kylecombes/poe-3d-ir-scanner/report/PoE-lab-2-report.pdf

# PoE Lab 2 - 3D Scanner

## Kyle Combes and Rachel Hwang

## September 26, 2017

Abstract

In this lab, we used an Arduino, two servos, and an infrared rangefinder to construct a 3D plot of a large ’R’ cut out of cardboard. Data was minorly preprocessed on the Arduino before being sent to a computer via serial for more processing and display. In the end, a 3D scatter plot was generated depicting the scanned object.

## 1 Constructing the 3D Scanner

Using SolidWorks, we designed parts to create a 3D scanner that includes two hobby servo motors and an infrared distance sensor. All parts were made intended to be laser cut out of 3/16” hardboard that could be wedged together. The bottom servo motor sat in a box base acting as the panning mechanism. Attached above to the side is the second servo motor creating the tilt mechanism for the sensor attached in the middle of the two axes. This ensured that the sensor’s center would not change when it panned or tilted.
Our SolidWorks model can be seen in Figure 1, and our final, physical scanner can be seen in Figure 2.

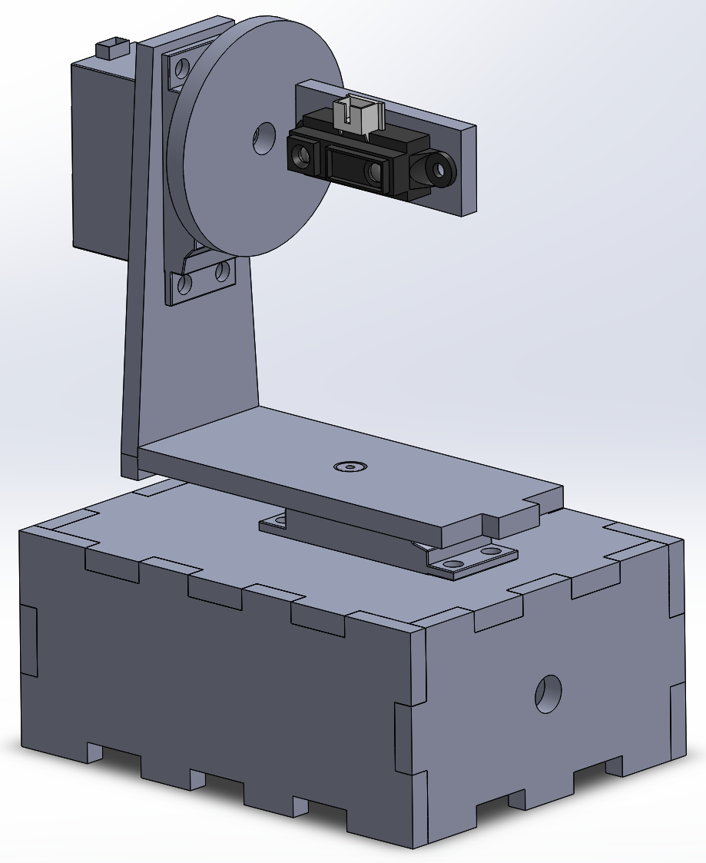
[picture p3: figure]

### Figure 1: The SolidWorks model of the 3D scanner

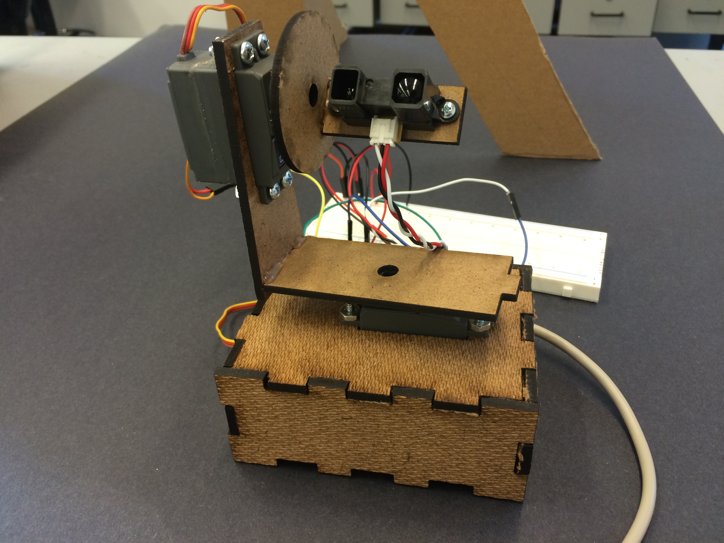
[picture p4: figure]

### Figure 2: The model made from laser cut hardwood of the 3D scanner

## 2 Calibrating the Rangefinder

The first step to using a rangefinder to accurately measure distances was to calibrate it. This would allow us to convert the value read from the sensor to an actual distance.
The value read from the IR sensor was in the range of 0 to 1023, since the Arduino uses a 10-bit analog to digital converter to read the input voltage. However, it seemed like an unnecessary extra step to us to convert this value to a voltage and then map that voltage to a distance value. Thus, we decided to directly map the 10-bit value to a distance in inches.
To calibrate the sensor, we placed a large piece of cardboard in front of the IR sensor. Using the serial monitor in the Arduino IDE, we observed the raw readings from the IR sensor and picked the mode of ten to twenty consecutive readings to be our measured value for that distance. Then we moved the cardboard back two to three inches and repeated the process. Our collected data can be seen in Figure 3.

### Switching our independent and dependent variables allowed us to look at the distance as a

function of sensor reading. Using the polyfit function in MATLAB, we were able to extract the

### quartic function y = 5.24 × 10⁻⁹x

4 − 8.33 × 10⁻⁶x

3 + 4.83 × 10⁻³x
2 − 1.26x + 1.41 × 10²

### , which

related the raw sensor reading to the distance. This is illustrated in Figure 4.

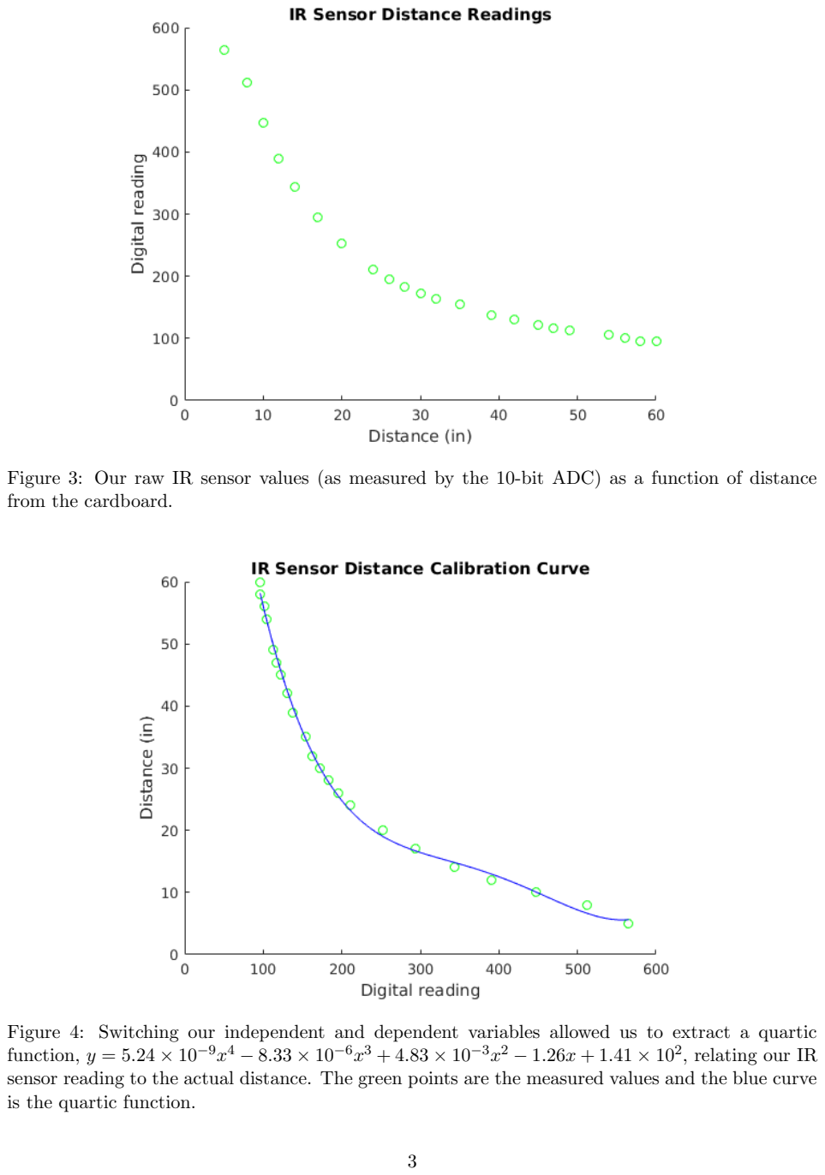
[picture p5: page 3]

Figure 3: Our raw IR sensor values (as measured by the 10-bit ADC) as a function of distance from the cardboard.

Figure 4: Switching our independent and dependent variables allowed us to extract a quartic

### function, y = 5.24 × 10⁻⁹x

4 − 8.33 × 10⁻⁶x

3 + 4.83 × 10⁻³x
2 − 1.26x + 1.41 × 10²

### , relating our IR

sensor reading to the actual distance. The green points are the measured values and the blue curve is the quartic function.

## 2.1 Error Plot

In order to check our calibration, we took some new measurements at various distances from the cardboard and checked the output of our function against the actual distance measurements. If our calibration were perfect, all of the points would lie on the line y = x because there would be a 1:1 correlation between the measured and actual values. In practice, the calculated values were typically within an inch of the correct value (see Figure 5).
However, it appears that the error would be significantly decreased if the line were shifted slightly to the left. This discrepancy could be due to the fact that the calibration and error plots were done under different lighting conditions (daytime and nighttime). The sunlight during the calibration session could’ve shifted all of the readings (since sunlight contains IR light). Without that constant influx, the readings would’ve all shifted by the same amount.

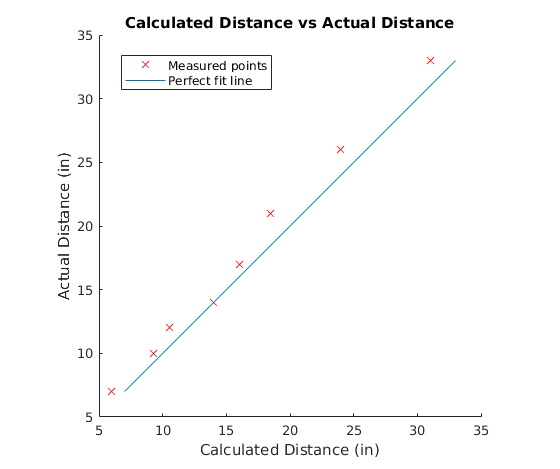
[picture p6: figure]

Figure 5: Some testing of our calibration curve showed that we were typically interpreted the distance within 1 inch of its correct value. However, the data may have been skewed slightly due to different lighting conditions during calibration and testing.

## 3 Collecting the Scan Data with the Arduino

Once the IR rangefinder was calibrated and mounted, we programmed the Arduino to sweep back and forth, collecting data points. Since we were panning and tilting about the origin and reading distances from the origin, this meant we were dealing with spherical coordinates. We decided to deal entirely with spherical coordinates on the Arduino and send them to the computer in that format.
We defined θmin, θmax, φmin, and φmax to restrict our ranges to 80 ≤ θ ≤ 100 and 75 ≤ φ ≤ 120. This helped minimize scanning time and avoid scanning unwanted nearby objects. We also defined thetaStep and phiStep to determine our angle deltas for each step. We settled on a value of 1 for both, so that we collected points every degree in each direction.

### To actually collect the data, the Arduino began with the pan servo at θmin and the tilted

servo at φmin. It then sampled the IR sensor twenty times and computed the mean distance, in order to avoid any erroneous readings throwing us off. Once it computed the mean, the value was transmitted to the computer along with the values for θ and φ as a tab-separated string.
Then, if θ was at the end of its range, the scanner tilted, collected another scan point, and reversed thetaStep to pan in the other direction. Once the scanner reached θmax and φmax, it reversed directions and began the scan again.

## 4 Visualizing the Scan

### On the computer, a Python program received the data sent by the Arduino over serial. Upon

receiving a transmission, several steps were required before a final figure could be generated.

## 4.1 Converting from Spherical to Cartesian

The first steps to handling the Arduino transmission were to decode the tab-separated string of values and convert them from spherical coordinates to Cartesian using the following equations (where r was the measured distance and θ and φ were the angles, as illustrated in Figure 6).

### x = rsin(φ)cos(θ)

### y = rsin(φ)sin(θ)

### z = rcost(φ)

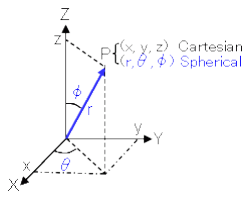
[picture p7: figure]

Figure 6: The spherical coordinate system used by the 3D scanner. Points were converted to Cartesian on the computer before plotting.

Once the point was converted to Cartesian, it was stored in a PointsCollection data structure. The PointsCollection data structure was designed to be configurable to only store a certain number of points such that, once the limit was reached, the oldest data point would be dropped. This allowed the scanner to keep running and scan new objects, discarding the oldest points as it progressed. For our scans, we decided to only keep one point for each value of θ and φ, so our max number of points was (θmax − θmin)(φmax − φmin) = 900.

## 4.2 Taking a 2D Scan

Taking a cross-sectional slice of the ’R’ (just above where the lines converged in the middle) resulted in Figure 7. In order to take the scan, the full pan-tilt setup (Figure 2) was used, but the tilt functionality was simply disabled.
At the bottom of the scan, where y < 20, you can see where the scanner picked up the middle of the R. The rest of the points at further distances are either noise or objects picked up in the background.

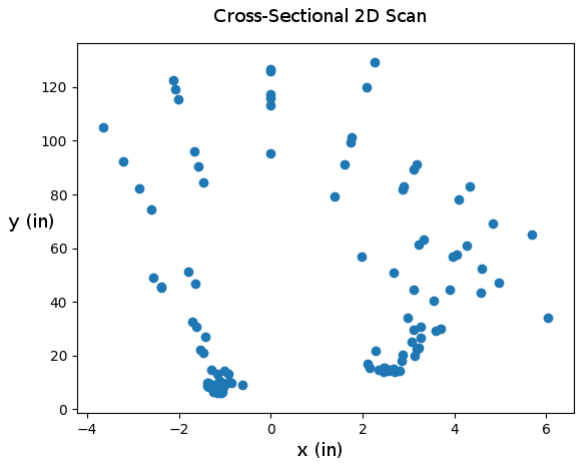
[picture p8: figure]

Figure 7: Taking a 2D scan of the middle of the ’R’ (just above where the lines converge in the middle of the letter) results in a cross-sectional view of the letter. At the bottom of the scan, where y < 20, you can see where the scanner picked up the R.

## 4.3 Cleaning the Data

We also defined a parameter in our program, MAX DIST, to ignore points more than a specific distance from the scanner. This helped to filter out anything the scanner picked up behind the object we were attempting to scan. Since we placed the letter we were scanning about 10-15 inches away from the scanner, we decided 30 inches was a good cutoff point. This way we could see if the scanner ever got confused and thought that the letter was a little further away than it actually was, but we also avoided plotting any background objects.

## 4.4 Plotting the Points

Once the points were filtered and converted to Cartesian, we plotted them in 3D using the Python library matplotlib. The results can be seen in Figure 8.


Figure 8: Our scanned cardboard letter ”R” after minimal filtering.

## 5 Conclusion

All in all, our scanner performed quite admirably. We initially ran into some trouble with inconsistent distance readings, which caused our object to be indistinguishable on the scan, but we learned that the IR sensor needed around 50ms to perform a scan and adjusted our code accordingly. This made the scan much, much cleaner.
Even so, there was a fair bit of noise in the top-right corner. We think this might be due to inconsistent servo tilt deltas, as it often appeared as though the scanner tilted more some times than others. However, the slanted leg of the ’R’ appeared pretty crisp, so perhaps it was not the cause. Confirming or disproving this would require closer monitoring of the scanner during scanning and perhaps measures the changes in the angle.
The ground is also noticeable in the bottom of the scan, but that is just an artifact caused by the conditions of the scan. To get rid of it (without simply cropping the image), one would have to suspend the letter in the air, perhaps with some thin thread. But that’s beyond the scope of this project.

## 6 Code

The full source code can also be found in this GitHub repository.

## 6.1 MATLAB Calibration

1 | % C ali b r a ti o n data
2 | d i s t = [ 5 8 10 12 14 17 20 24 26 28 30 32 35 39 42 45 47 49 54 56 58 6 0 ] ;
3 | r e a di n g = [ 5 6 5 512 447 390 343 294 252 211 195 183 172 163 154 138 130 122 117 113
| 105 101 96 9 6 ] ;

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

% Pl o t the p oi n t s
pl o t ( di s t , re adin g , ’ go ’ ) ;

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

%% Make an e r r o r pl o t
c a l c u l a t e d = [ 6 9. 3 1 0. 5 14 16 1 8. 5 24 3 1 ] ; a c t u al = [ 7 10 12 14 17 21 26 3 3 ] ;

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

## 6.2 Arduino

#i n cl u d e <Servo . h>

#d e f i n e IR SENSOR A0

#d e f i n e PAN SERVO 3

#d e f i n e TILT SERVO 5

#d e f i n e THETA MIN 80

#d e f i n e THETA MAX 100 #d e f i n e PHI MIN 75

#d e f i n e PHI MAX 120

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

S t ri n g r e s u l t=”” ;

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

}

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

}
servoPan . w ri t e ( t h e t a ) ;

}

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

}
s e r v o T i l t . w ri t e ( phi ) ;

}

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

v oid l o o p ( ) {

// Take a re adin g , add i t t o our runnin g sum , and inc remen t our re ad c o u n t e r distanceSum += readDis tF romSenso r ( ) ;
readCount++;

i f ( readCount == READINGS PER ANGLE) {

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

// Rese t c o u n t e r and sum
distanceSum = 0 . 0 ;
readCount = 0 . 0 ;

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

}

}

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

}

}

// Move the s e r v o
se tThe t a ( t h e t a ) ;

}

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

// I f we ’ ve gone p a s t the max o r min , change d i r e c t i o n s and go back the o t h e r way
i f ( phi > PHI MAX | | phi < PHI MIN ) {
S e r i a l . p r i n t l n ( r e s u l t + ”Phi t o o bi g / sm all ! ” + phi + ” vs ” + PHI MAX) ;
phiS tep = −phiS tep ;
phi += 2∗ phiS tep ;

}

// Move the s e r v o
s e tP hi ( phi ) ;

}

// Get the di s t a n c e ( i n i n c h e s ) measured by the IR s e n s o r
f l o a t readDis tF romSenso r ( ) {
// Sl ope and i n t e r c e p t de te rmined by c a l i b r a t i o n expe rimen t
f l o a t d = ( f l o a t ) analogRead ( IR SENSOR) ;
// Convert r e a di n g t o i n c h e s
r e t u r n 0. 0 0 0 0 0 0 0 0 5 2 4 6 5∗d∗d∗d∗d − 0. 0 0 0 0 0 8 3 2 5 5∗d∗d∗d + 0. 0 0 4 8 3∗d∗d − 1. 2 5 7 8∗d + 1 4 1;

}

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

}

## 6.3 Computer

1 #! / u s r / l o c a l / bin /python

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

7

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

15

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

43
44 | # | I n i t i a l i z e s t u f f
45 | cxn = S e r i a l ( ’ / dev /ttyACM0 ’ , b aud r a te =9600)
46 | p oi n t s = P oi n t C oll e c ti o n (NUM POINTS TO KEEP)

47

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

68

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

78

79
80 | f i g = p y pl o t . f i g u r e ( )
81 | f i g . show ( ) | # Show the f i g u r e
82 | ax = f i g . a d d s u b pl o t ( 1 1 1 , p r o j e c t i o n=’ 3d ’ ) | # Se t up 3D pl o t
83 | w hil e True :
84 | ( di s t , the t a , phi ) = r e a d s e r i a l ( )
85 | i f d i s t :
86 | ( x , y , z ) = s p h e r i c a l t o c a r t e s i a n ( di s t , the t a , phi )
87 | i f y < MAX DIST:
88 | p oi n t s . a d d p oi n t ( Poin t ( x , y , z ) )
89 | # P ri n t out the r e c e i v e d data t o the c o n s ol e , j u s t i n c a s e we need t o
debug
90 | p r i n t ( ’ Radius : { 0 : 0 . 3 f }\ tTheta : { 1 : 0 . 3 f }\ tPhi : { 2 : 0 . 3 f }\ tx : { 3 : 0 . 3 f }\ ty
: { 4 : 0 . 3 f }\ t z : { 5 : 0 . 3 f } ’ . forma t ( di s t , the t a , phi , x , y , z ) )
91 | # Pl o t our sc an
92 | ax . c l a ( ) | # Cle a r f i g u r e
93 | ax . s c a t t e r ( p oi n t s . g e t x v a l u e s ( ) , p oi n t s . g e t y v a l u e s ( ) , p oi n t s .
g e t z v a l u e s ( ) )
94 | p y pl o t . draw ( ) | # Redraw the f i g u r e
95 | p y pl o t . pause ( 0 . 0 0 1 ) | # Wait f o r i t t o r e n d e r
96 | e l s e :
97 | # P ri n t out the r e c e i v e d data t o the c o n s ol e , j u s t i n c a s e we need t o
debug
98 | p r i n t ( ’Out o f r an ge : Radius : { 0 : 0 . 3 f }\ tTheta : { 1 : 0 . 3 f }\ tPhi : { 2 : 0 . 3 f }\ tx
: { 3 : 0 . 3 f }\ ty : { 4 : 0 . 3 f }\ t z : { 5 : 0 . 3 f } ’ . forma t ( di s t , the t a , phi , x , y , z ) )
