kylecombes/poe-3d-ir-scanner/(commit log)

2017-09-15 Radius and theta being sent from Arduino to computer and parsed successfully.
2017-09-24 Fixed spherical to cartesian bug
    [SendReceive.py, lab2.ino]
2017-09-24 Trying to fix 3D scanning
    [SendReceive.py, lab2.ino]
2017-09-26 Recalibrated sensor
